emilyanthony4244/Soldering_Workshop/README.md

# Soldering_Workshop
Soldering Workshop design files for teaching at makerspaces and conventions.

# Schematic
schematic
