emilyanthony4244/Soldering_Workshop/schematic.pdf

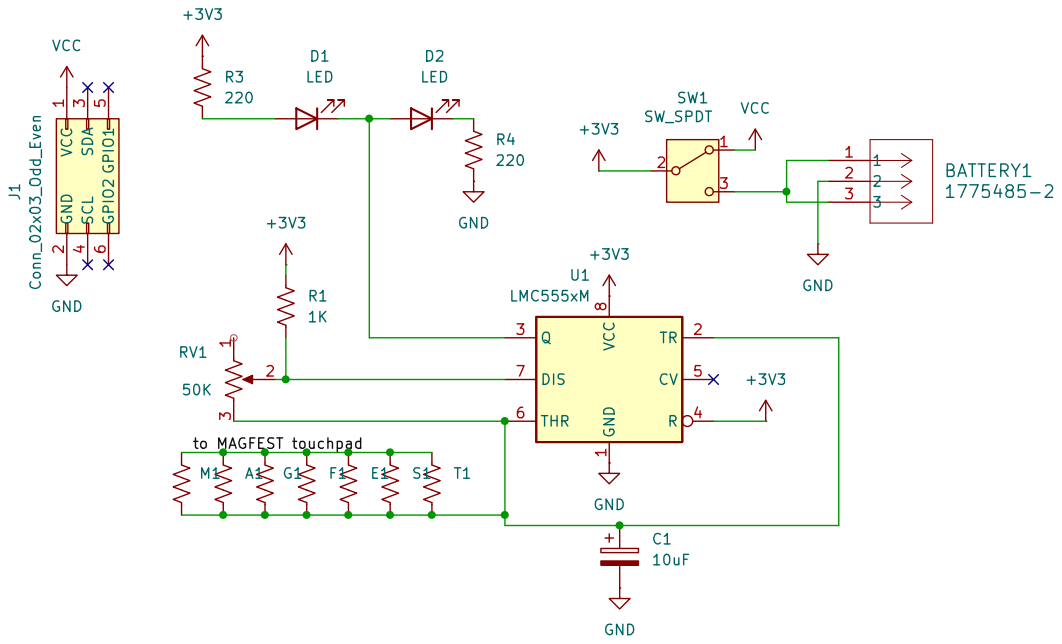
[picture p1: page 1]
