emilyanthony4244/Soldering_Workshop/Soldering Workshop SAO.kicad_pcb

## KiCad design Soldering Workshop SAO.kicad_pcb (2024-11-15)

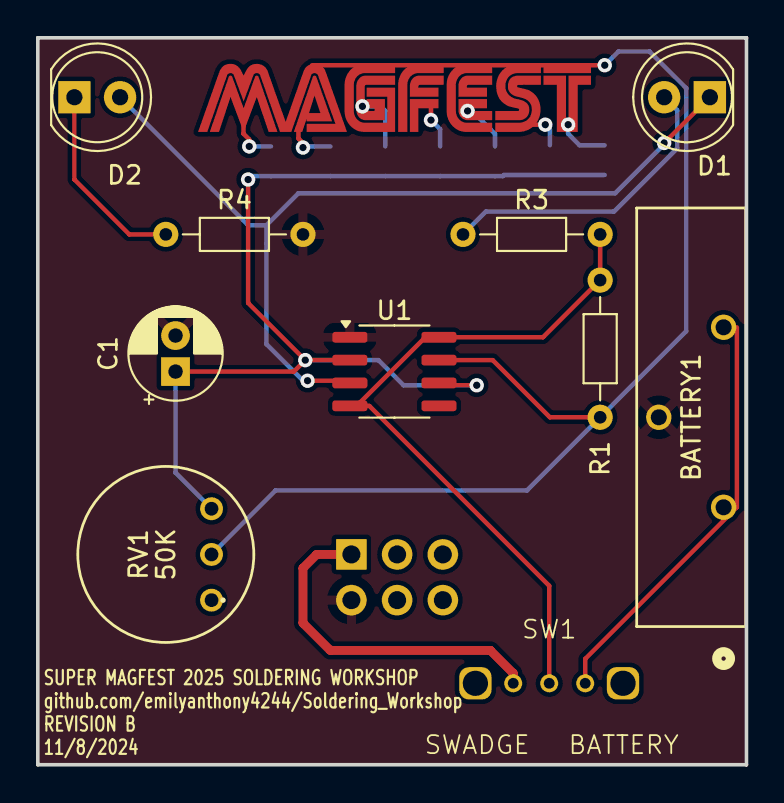
[picture p2: board Soldering Workshop SAO.kicad_pcb from above]

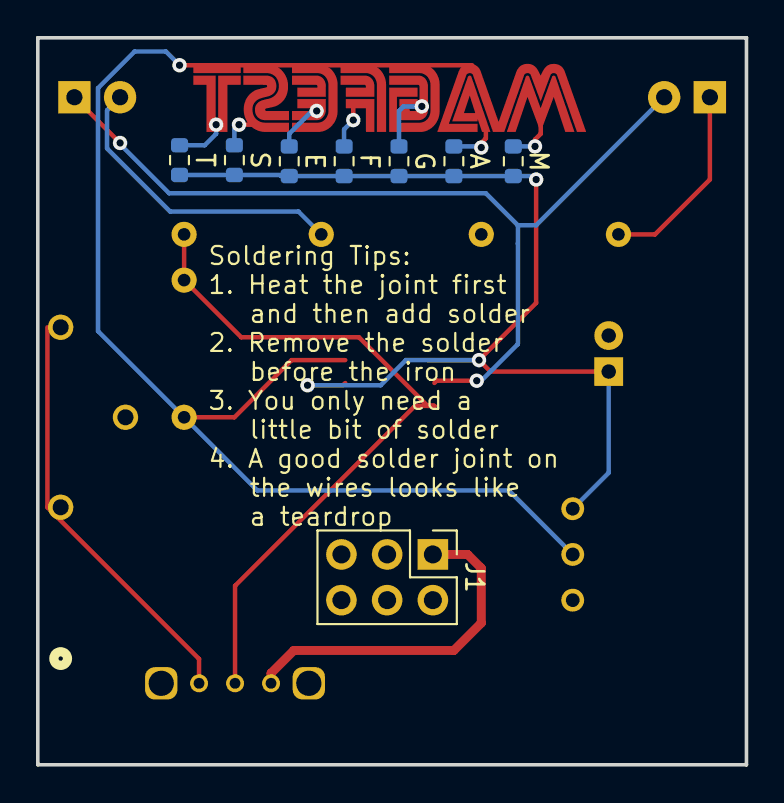
[picture p3: board Soldering Workshop SAO.kicad_pcb from below]

Board: 2 copper layers, 39.4 x 40.4 mm, 18 parts (8 on the bottom side), 9 nets.

Parts:
A: R_0603_1608Metric
BATTERY1: 1775485-2; CONN3_1775485-1_TEC
C1: 10uF; CP_Radial_D5.0mm_P2.00mm
D1, D2: LED; LED_D5.0mm
E: R_0603_1608Metric
F: R_0603_1608Metric
G: R_0603_1608Metric
J1: Conn_02x03_Odd_Even; PinHeader_2x03_P2.54mm_Vertical
M: R_0603_1608Metric
R1: 1K; R_Axial_DIN0204_L3.6mm_D1.6mm_P7.62mm_Horizontal
R3, R4: 220; R_Axial_DIN0204_L3.6mm_D1.6mm_P7.62mm_Horizontal
RV1: 50K; 91AR50KLF
S: R_0603_1608Metric
SW1: SW_SPDT; SLW-864574-5A-RA-N-D
T: R_0603_1608Metric
U1: LMC555xM; SOIC-8_3.9x4.9mm_P1.27mm

Connections:
+3V3: R1.1, R3.2, SW1.2 (B), U1.4 (R), U1.8 (VCC)
GND: BATTERY1.2, C1.2, J1.2 (GND), R4.2, U1.1 (GND)
unnamed: D1.2 (A), R3.1
unnamed: D1.1 (K), D2.2 (A), U1.3 (Q)
unnamed: D2.1 (K), R4.1
unnamed: BATTERY1.1, BATTERY1.3, SW1.3 (C)
unnamed: R1.2, RV1.2, U1.7 (DIS)
unnamed: A.2, C1.1, E.2, F.2, G.2, M.2, RV1.3, S.2, T.2, U1.2 (TR), U1.6 (THR)
VCC: J1.1 (VCC), SW1.1 (A)
