emilyanthony4244/Soldering_Workshop/(commit log)

2024-11-01 Rev A
    Rev A sent to PCBway
    [Soldering Workshop SAO.kicad_pcb, Soldering Workshop SAO.kicad_sch]
2024-11-08 Revision B
    do not blindly trust schematics you find on the internet
    Connect Th to Tr
    Disconnect RV1 from GND
    Connect RV1 to Th
    Flip D1
    Put D1 on silk
    put MAGFEST on the schematic
    [Soldering Workshop SAO.kicad_pcb, Soldering Workshop SAO.kicad_sch]
2024-11-15 Rev B
    [Soldering Workshop SAO.kicad_pcb]
2025-01-16 Update MAGFest 2025 Soldering Workshop.pptx
2025-02-14 cleanup data, readme
    [Soldering Workshop SAO.csv, Soldering Workshop SAO.kicad_sch]
